wuhuzzk/RM2025_SuperCapController_G4_FMAC/(list of files, drawings)

Other design files:
Hardware/RM2025_超级电容控制器_IMCA.eprj
