wuhuzzk/RM2025_SuperCapController_G4_FMAC/Core/Src/main.c

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
/* Includes ------------------------------------------------------------------*/
#include "main.h"
#include "adc.h"
#include "dma.h"
#include "fdcan.h"
#include "fmac.h"
#include "hrtim.h"
#include "iwdg.h"
#include "opamp.h"
#include "tim.h"
#include "usart.h"
#include "gpio.h"

/* USER CODE BEGIN Includes */
#include "Control_buck_boost.h"
#include "CanBusTask.h"
#include "Vofa_send.h"
#include "scheduler.h"
#include "uart_data_handle.h"

#include "Anotc.h"
/* USER CODE END Includes */


void SystemClock_Config(void);
/**
  * @brief  The application entry point.
  * @retval int
  */
int main(void)
{

  /* MCU Configuration--------------------------------------------------------*/

  /* Reset of all peripherals, Initializes the Flash interface and the Systick. */
  HAL_Init();

  /* Configure the system clock */
  SystemClock_Config();

  /* Initialize all configured peripherals */
  MX_GPIO_Init();
  MX_DMA_Init();
  MX_HRTIM1_Init();
  MX_ADC1_Init();
  MX_ADC2_Init();
  MX_ADC3_Init();
  MX_ADC4_Init();
  MX_ADC5_Init();
  MX_OPAMP1_Init();
  MX_OPAMP4_Init();
  MX_USART1_UART_Init();
  MX_USART3_UART_Init();
  MX_OPAMP2_Init();
  MX_TIM1_Init();
  MX_FDCAN1_Init();
  MX_IWDG_Init();
  MX_FMAC_Init();
  /* USER CODE BEGIN 2 */

  PID_struct_init(&pid_battery_power, DELTA_PID, 15, -15, 15, -15, 0.05f, 0.00055f, 0.0f); // 误差补偿功率环
  PID_struct_init(&pid_power_buffer, DELTA_PID, 10, -2, 10, -2, 1.0f, 0.1f, 0.0f);

  HAL_Delay(10);
  HAL_Delay(50);
  HAL_ADCEx_Calibration_Start(&hadc1, ADC_SINGLE_ENDED);
  HAL_Delay(10);
  HAL_ADC_Start_DMA(&hadc1, (uint32_t *)&ADC_RawData.adc_Chassis_I, 1);
  HAL_Delay(10);
  HAL_ADCEx_Calibration_Start(&hadc2, ADC_SINGLE_ENDED);
  HAL_Delay(10);
  HAL_ADC_Start_DMA(&hadc2, (uint32_t *)&ADC_RawData.adc_Battery_I, 1);
  HAL_ADCEx_Calibration_Start(&hadc3, ADC_SINGLE_ENDED);
  HAL_Delay(10);
  HAL_ADC_Start_DMA(&hadc3, (uint32_t *)&ADC_RawData.adc_Pin24V_Battery_V, 1);
  HAL_ADCEx_Calibration_Start(&hadc4, ADC_SINGLE_ENDED);
  HAL_Delay(10);
  HAL_ADC_Start_DMA(&hadc4, (uint32_t *)&ADC_RawData.adc_Cap_V, 1);
  HAL_Delay(10);
  HAL_ADCEx_Calibration_Start(&hadc5, ADC_SINGLE_ENDED);
  HAL_Delay(10);

  HAL_ADC_Start_DMA(&hadc5, (uint32_t *)&ADC_RawData.adc_Cap_I, 1);

  HAL_OPAMP_Start(&hopamp1);
  HAL_OPAMP_Start(&hopamp2);
  HAL_OPAMP_Start(&hopamp4);

  HAL_HRTIM_WaveformCountStart(&hhrtim1, HRTIM_TIMERID_TIMER_B | HRTIM_TIMERID_TIMER_A | HRTIM_TIMERID_MASTER );
  HAL_UART_Receive_IT(&huart3, &aRxBuffer, 1);

  CANFilterInit();

  Auotc_Init();

  HAL_GPIO_WritePin(LED3_GPIO_Port, LED3_Pin, 1);

  HAL_GPIO_WritePin(LED2_GPIO_Port, LED2_Pin, 1);

  HAL_TIM_Base_Start_IT(&htim1);

  HAL_UART_Receive_IT(&huart3, &aRxBuffer, 1);
  HAL_Delay(10);

  Scheduler_init();

  // 取消下方两行注释，取消上电自启动
  // Scheduler_stop(Start_task);
  // Scheduler_stop(average1S);

  Scheduler_stop(UVLO);

  hiwdg.Init.Reload = 200;
 HAL_IWDG_Init(&hiwdg);

  /* USER CODE END 2 */

  /* Infinite loop */
  /* USER CODE BEGIN WHILE */
  while (1)
  {

    Scheduler_run();
    /* USER CODE END WHILE */

    /* USER CODE BEGIN 3 */
  }
  /* USER CODE END 3 */
}

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
