wuhuzzk/RM2025_SuperCapController_G4_FMAC/RM2025_SuperCapController_G4_FMAC.ioc

Mcu.UserName=STM32G474RBTx
PA10.Signal=HRTIM1_CHB1
PA11.Signal=HRTIM1_CHB2
PA13.Signal=SYS_JTMS-SWDIO
PA14.Signal=SYS_JTCK-SWCLK
PA2.GPIO_Label=BUZZ
PA2.Signal=GPIO_Output
PA3.Signal=OPAMP1_VINP
PA7.Signal=OPAMP2_VINP
PA8.Signal=HRTIM1_CHA1
PA9.Signal=HRTIM1_CHA2
PB1.Signal=ADC3_IN1
PB11.Signal=OPAMP4_VINP
PB14.Signal=ADC4_IN4
PB6.Signal=USART1_TX
PB7.Signal=USART1_RX
PB8-BOOT0.Signal=FDCAN1_RX
PB9.Signal=FDCAN1_TX
PC0.GPIO_Label=LED1
PC0.Signal=GPIO_Output
PC1.GPIO_Label=LED2
PC1.Signal=GPIO_Output
PC10.Signal=USART3_TX
PC11.Signal=USART3_RX
PC2.GPIO_Label=LED3
PC2.Signal=GPIO_Output
PF0-OSC_IN.Signal=RCC_OSC_IN
PF1-OSC_OUT.Signal=RCC_OSC_OUT
