wuhuzzk/RM2025_SuperCapController_G4_FMAC/Core/Inc/main.h

#define LED1_Pin GPIO_PIN_0
#define LED1_GPIO_Port GPIOC
#define LED2_Pin GPIO_PIN_1
#define LED2_GPIO_Port GPIOC
#define LED3_Pin GPIO_PIN_2
#define LED3_GPIO_Port GPIOC
#define BUZZ_Pin GPIO_PIN_2
#define BUZZ_GPIO_Port GPIOA
